Advait-B/cg2271_project/schematics/Doomscroll Breaker Schematic.png

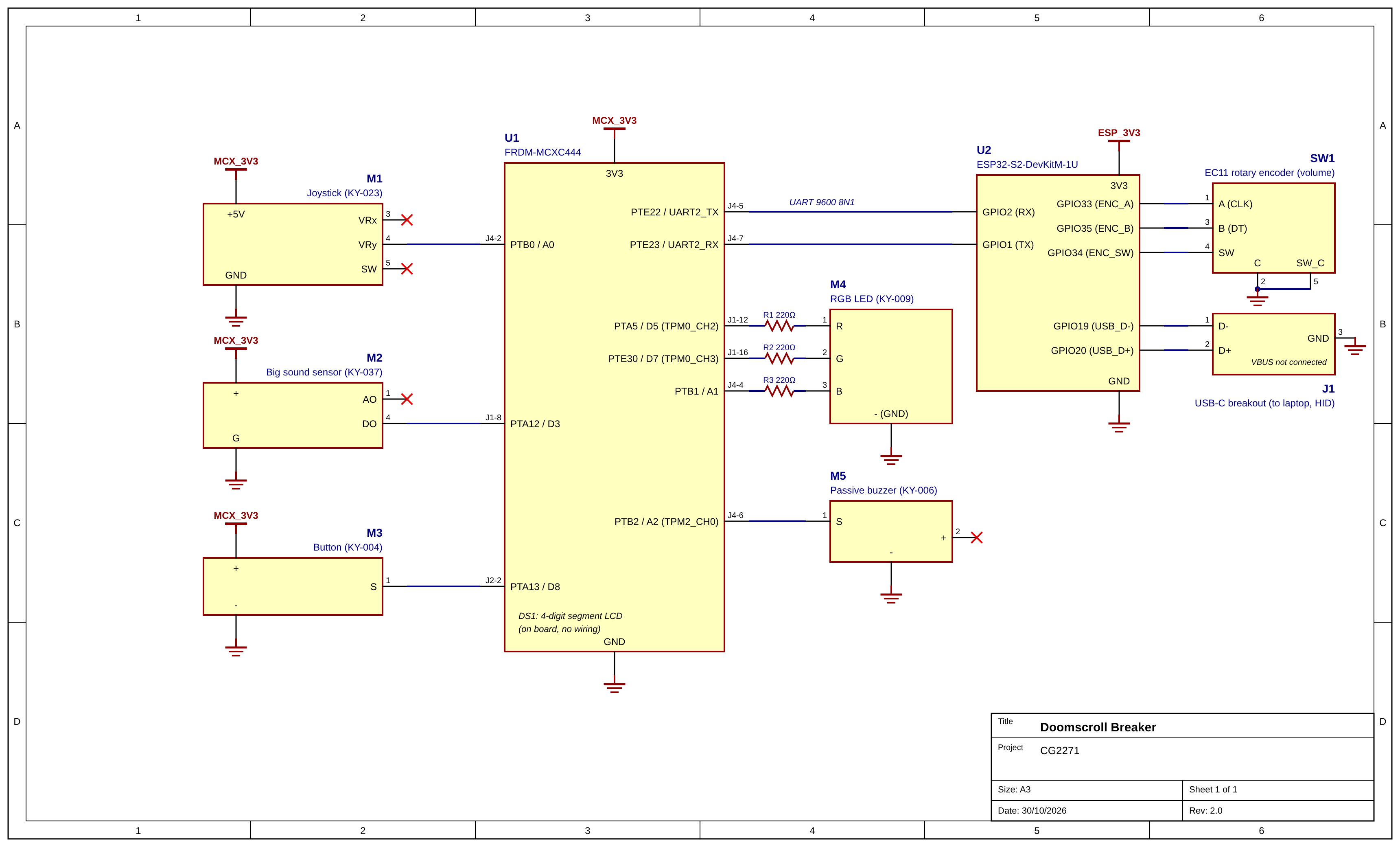
schematics/Doomscroll Breaker Schematic.png
