Advait-B/cg2271_project/hardware/stl_rev2/button_plunger.stl

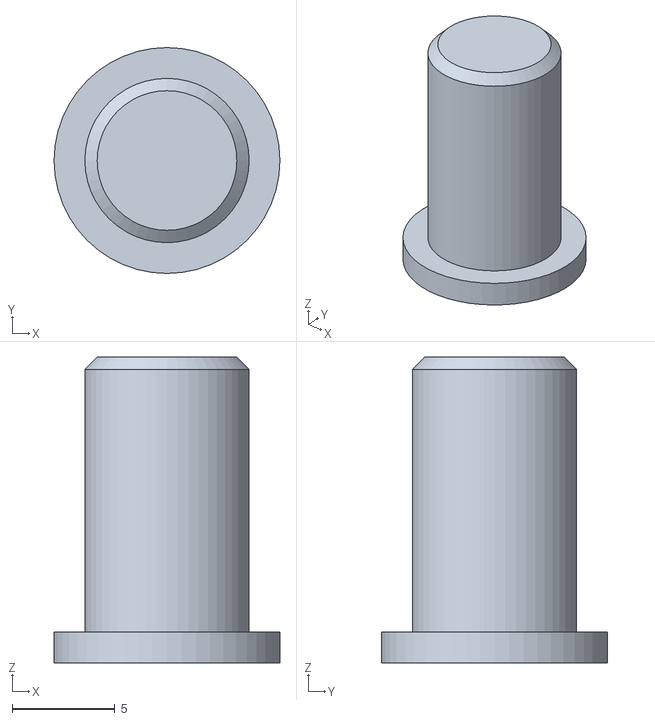
[picture p2: CAD file, 2026-10-30]
hardware/stl_rev2/button_plunger.stl
11.0 x 11.0 x 14.9
