Advait-B/cg2271_project/hardware/stl_rev2/led_light_pipe.stl

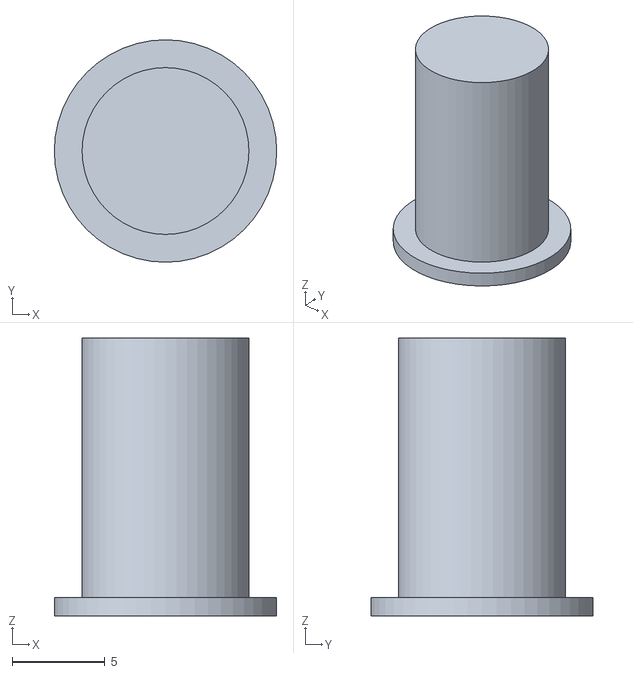
[picture p3: CAD file, 2026-10-30]
hardware/stl_rev2/led_light_pipe.stl
12.0 x 12.0 x 15.0
