Advait-B/cg2271_project/hardware/stl_rev2/case_lcd_bezel.stl

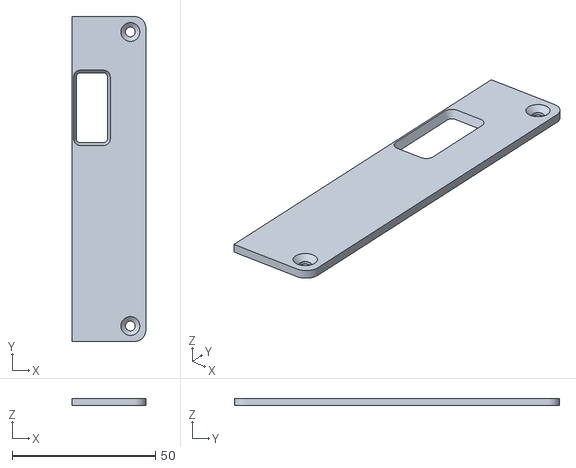
[picture p4: CAD file, 2026-10-30]
hardware/stl_rev2/case_lcd_bezel.stl
25.7 x 113.3 x 2.40
