Advait-B/cg2271_project/hardware/stl_rev2/ec11_knob_D_shaft.stl

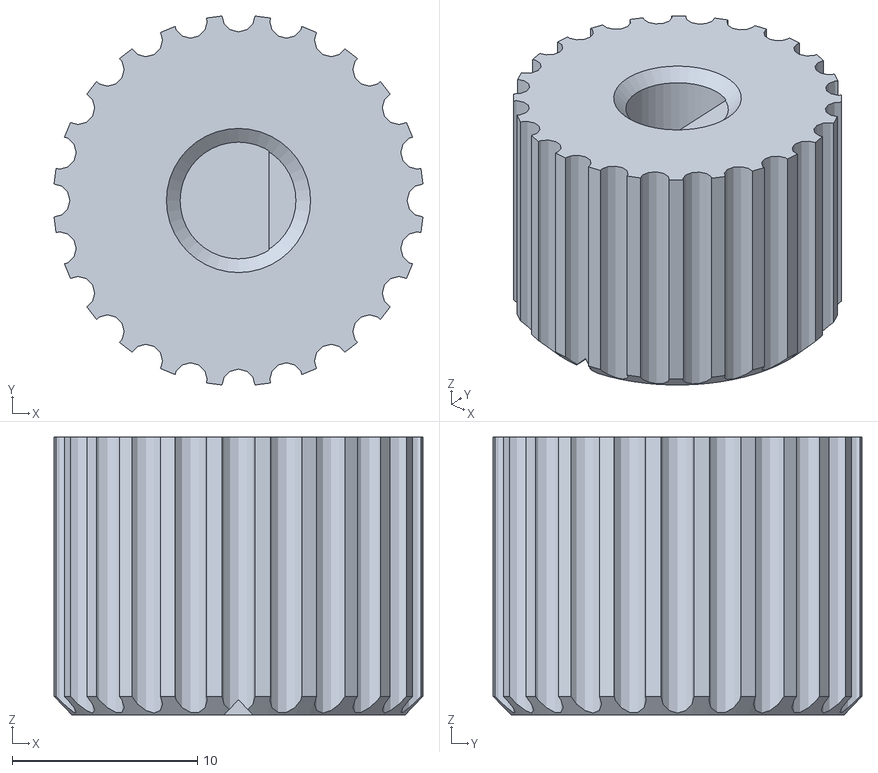
[picture p5: CAD file, 2026-10-30]
hardware/stl_rev2/ec11_knob_D_shaft.stl
19.9 x 19.9 x 15.0
