Advait-B/cg2271_project/hardware/stl_rev2/case_top.stl

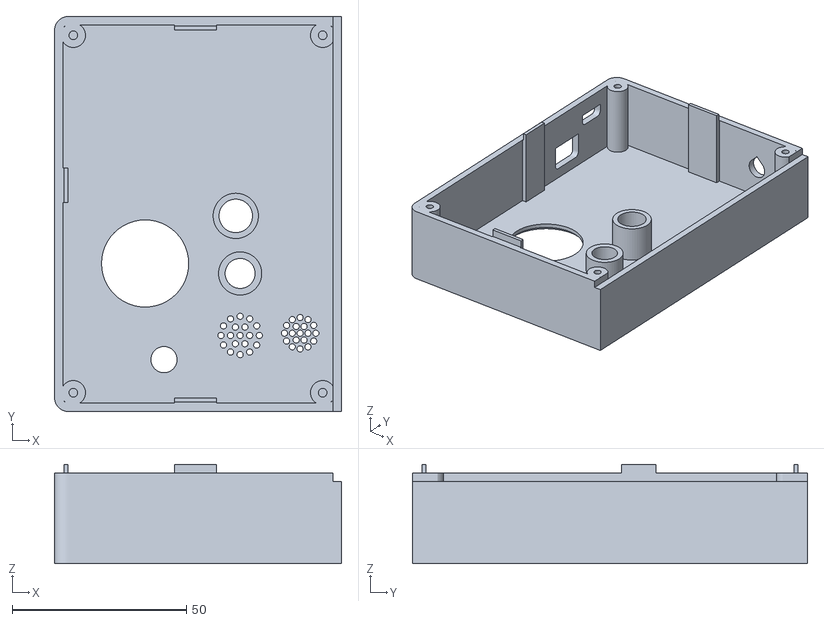
[picture p6: CAD file, 2026-10-30]
hardware/stl_rev2/case_top.stl
82.3 x 113.3 x 28.5
