Advait-B/cg2271_project/hardware/stl_rev2/case_base.stl

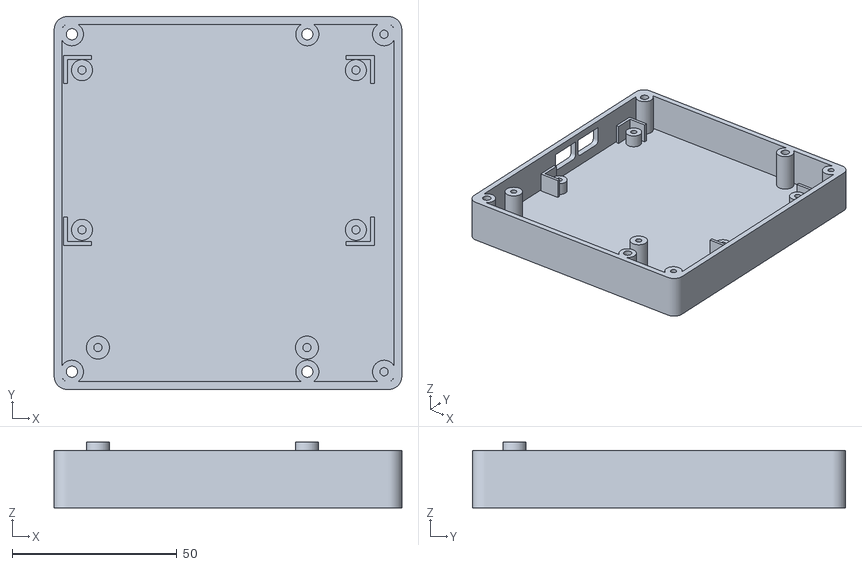
[picture p7: CAD file, 2026-10-30]
hardware/stl_rev2/case_base.stl
105.6 x 113.3 x 19.9
