Advait-B/cg2271_project/hardware/stl_rev2/fit_test_coupon.stl

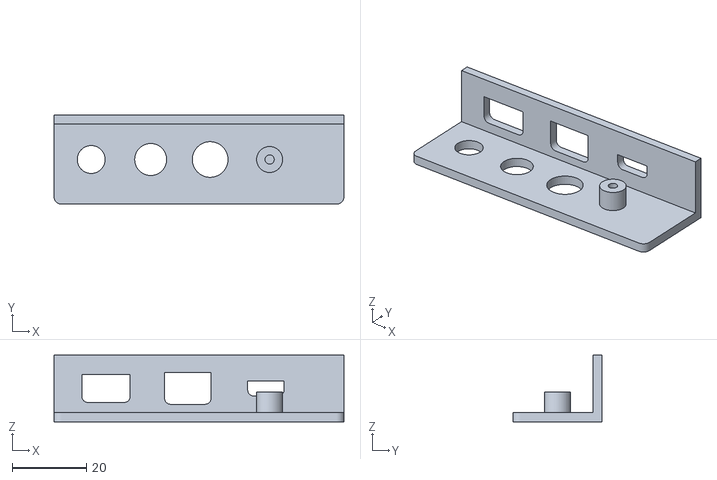
[picture p8: CAD file, 2026-10-30]
hardware/stl_rev2/fit_test_coupon.stl
78.0 x 24.0 x 18.0
