Advait-B/cg2271_project/(list of files, cad)

Other CAD files:
hardware/stl_rev2/ec11_knob_knurled_shaft.stl
