Advait-B/cg2271_project/hardware/Doomscroll Build Viewer.html

# Doomscroll Breaker

Shield + enclosure · FRDM-MCXC444 · ESP32-S2-DevKitM-1U Rev 2.0 · 30/10/2026

Shield.PcbDoc [3D] Enclosure.PcbDoc [3D] Shield.PcbDoc [Bottom]

View IsoTopFrontPortsBottom

Show U1 FRDMShieldModulesU2 ESP32WiresOptional wiresLabels

Case BaseTopBezelX-ray

Explode0 mm

Components

123456

123456

ABCD

ABCD

LMB orbit · wheel zoom · RMB pan · click to inspect

Y↓ front · X→ right · units mm

Properties Board

Nets Placement Build order BOM Print

Hole —X —Y —Grid 2.54 mm (100 mil)Layer TopBoard 67.5 × 89.5 mm

TitleDoomscroll Breaker · Shield & Enclosure

ProjectCG2271 Assignment 4

SizeA3 · 3D

HardwareFRDM-MCXC444 + ESP32-S2 + 45-in-1 kit

Date30/10/2026

Rev2.0 · Sheet 2 of 2
