Advait-B/cg2271_project/doomscroll_esp32_wifi/secrets.h

// Real keys - NOT committed to git (see .gitignore). Template: secrets.example.h
#pragma once

const char* WIFI_SSID = "dropout";
const char* WIFI_PASSWORD = "12345678";
const char* BOT_TOKEN = "8985396594:AAF6BTwWaWCQ5x8HEBO7DXcSR8ZPtQ0cdgk";
const char* FRIEND_CHAT_ID = "6130634739";
const char* USER_NAME = "yikssss";
const char* FIREBASE_URL = "https://cg2271-3371c-default-rtdb.asia-southeast1.firebasedatabase.app";
const char* FIREBASE_SECRET = "qqLZkpnUE3IM5i3DUVeEgMwXk3fWfG1bDUqmRume";
