Advait-B/cg2271_project/doomscroll_esp32/secrets.example.h

// Template for secrets.h. Only USER_NAME is used by the sketch; the laptop helper and tools read the rest.
#pragma once

const char* WIFI_SSID = "your-hotspot";
const char* WIFI_PASSWORD = "your-password";
const char* BOT_TOKEN = "123456789:telegram-bot-token-from-BotFather";
const char* FRIEND_CHAT_ID = "000000000";
const char* USER_NAME = "your-name";
const char* FIREBASE_URL = "https://your-project-default-rtdb.region.firebasedatabase.app";
const char* FIREBASE_SECRET = "firebase-database-secret";
