Advait-B/cg2271_project/(commit log)

2026-10-30 Doomscroll Breaker: FRDM-MCXC444 + ESP32-S2 + laptop helper + Chrome lock
    - mcxc444/: FreeRTOS firmware (budget 10, no ask cooldown, "dEny" on the LCD
    when the friend denies) + MCUXpresso project export
    - doomscroll_esp32/: USB keyboard/volume bridge, EC11 volume knob, Wi-Fi off;
    talks to the laptop over USB serial ($STATE/$ASK/$SESSION/$BUDGET, $DATE/$REPLY).
    Keys live in secrets.h (git-ignored); secrets.example.h is the template.
    - tools/doomscroll_keys.py: laptop helper (browser-lock server, Telegram
    Approve/Deny, Firebase writes, key/volume forwarding) + launcher scripts
    - extension/: Chrome extension that locks TikTok and Instagram unless the
    device is plugged in, open and has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
    [button_plunger.stl, case_base.stl, case_lcd_bezel.stl, case_top.stl, ec11_knob_D_shaft.stl, ec11_knob_knurled_shaft.stl, fit_test_coupon.stl, led_diffuser.stl]
2026-10-30 Fix firmware bugs and remove dead code
    FRDM:
    - NVIC priorities were raw values (64/128) that CMSIS shifts to 0; use levels 1/2
    - WAITING ("SEnt") could hang forever without the helper: short press cancels, 150 s timeout
    - remove the break-timer state, events and packets (MPU-6050 is gone)
    - UART RX hands frames to the task through a queue instead of buffer + semaphore + critical section
    - deny/ask timestamps live in Session; LCD pin enables built from named pin tables
    - PKT_ASK carries UNLOCK_BONUS so the Telegram text isn't hard-coded elsewhere
    - launch config: Debug\MCXC444_Project.axf -> Debug/MCXC444_Project.axf
    ESP32:
    - delete the unused on-board Wi-Fi/Telegram/Firebase path (USE_WIFI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
    [MCXC444_Project.c, doomscroll_esp32.ino, doomscroll_keys.py]
2026-10-30 Tidy tools, docs and hardware files; commit secrets.h
    - scripts find the repo from their own path instead of ~/Desktop/Y2S1/CG2271/Project
    - 11 wrappers -> 7: ESP32_upload.command replaces upload_esp32.sh, ESP32_compile_upload.command and
    ESP32_setup_and_upload.command; Telegram_test.command absorbs telegram_test.sh; ESP32_check removed
    - upload instructions no longer say to hold BOOT or monitor the FRDM's usbmodem port
    - setup no longer installs UniversalTelegramBot/ArduinoJson
    - README rewritten for the current design (wiring, demo, build, both protocols); stale load/upload
    guide removed; CLAUDE.md trimmed to current facts
    - remove hardware/stl (rev 1; rev 2 is in stl_rev2)
    - secrets.h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
    [button_plunger.stl, case_base.stl, case_lcd_bezel.stl, case_top.stl, led_diffuser.stl]
2026-10-30 Schematic rev 2: EC11 encoder replaces the MPU-6050
    - SW1 EC11 on ESP32 GPIO33 (A), GPIO35 (B), GPIO34 (SW); C and switch common to GND, internal pull-ups
    - J1 USB-C breakout on GPIO19 (D-) / GPIO20 (D+) for the HID keyboard
    - board renamed to ESP32-S2-DevKitM-1U, LED module to KY-009 (matches hardware/doomscroll_hw.py)
    - notes and title block updated; only the colour PNG is kept
    Claude-Session: https://claude.ai/code/session_01CbPK4z57ZN4e2hKZrAET3k
2026-10-30 Schematic: 220 ohm LED resistors, drop notes, shorter title block
    - R1-R3 220 ohm in series between U1 and the RGB LED's R, G, B
    - notes removed; title "Doomscroll Breaker", project "CG2271"
    - SVG source committed alongside the PNG
    - README wiring table lists the resistors (and the B channel)
    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
2026-11-11 Add Option 2 ESP32 sketch: on-board Wi-Fi (Telegram, Firebase, SNTP) with helper fallback
2026-11-11 Add updated demo code map (HTML source + PDF)
    Maps each Assignment 4 rubric item to file and line numbers in the
    current code: MCXC444_Project.c, the Wi-Fi ESP32 sketch, FreeRTOSConfig.h,
    the laptop helper and the browser extension. Replaces the stale map that
    referenced uartRxSem, USE_WIFI, checkNewDay and postToFirebase.
